JonathanXLin/calipot/README.md

# calipot
Potentiometer based caliper w/ 0.2 mm precision
