JonathanXLin/calipot/Schematic/Schematic Photo.PNG

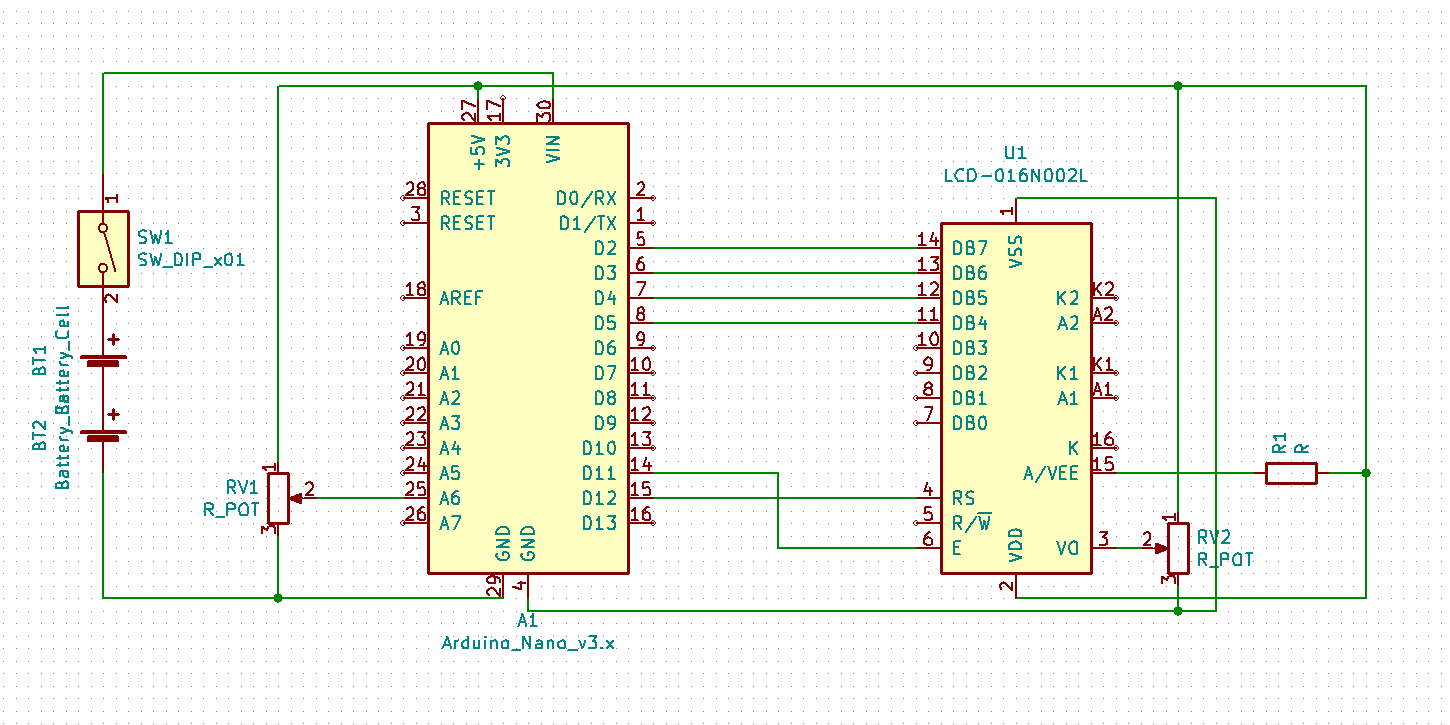
Schematic/Schematic Photo.PNG
