JonathanXLin/calipot/Models/Enclosure.STL

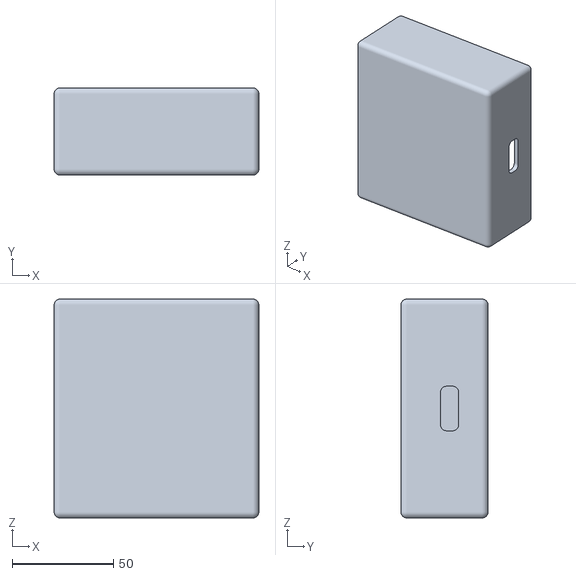
[picture p11: CAD file, 2018-12-14]
Models/Enclosure.STL
101.0 x 43.0 x 108.0
