JonathanXLin/calipot/Schematic/Schematic.kicad_pcb

## KiCad design circuitry/circuitry.sch

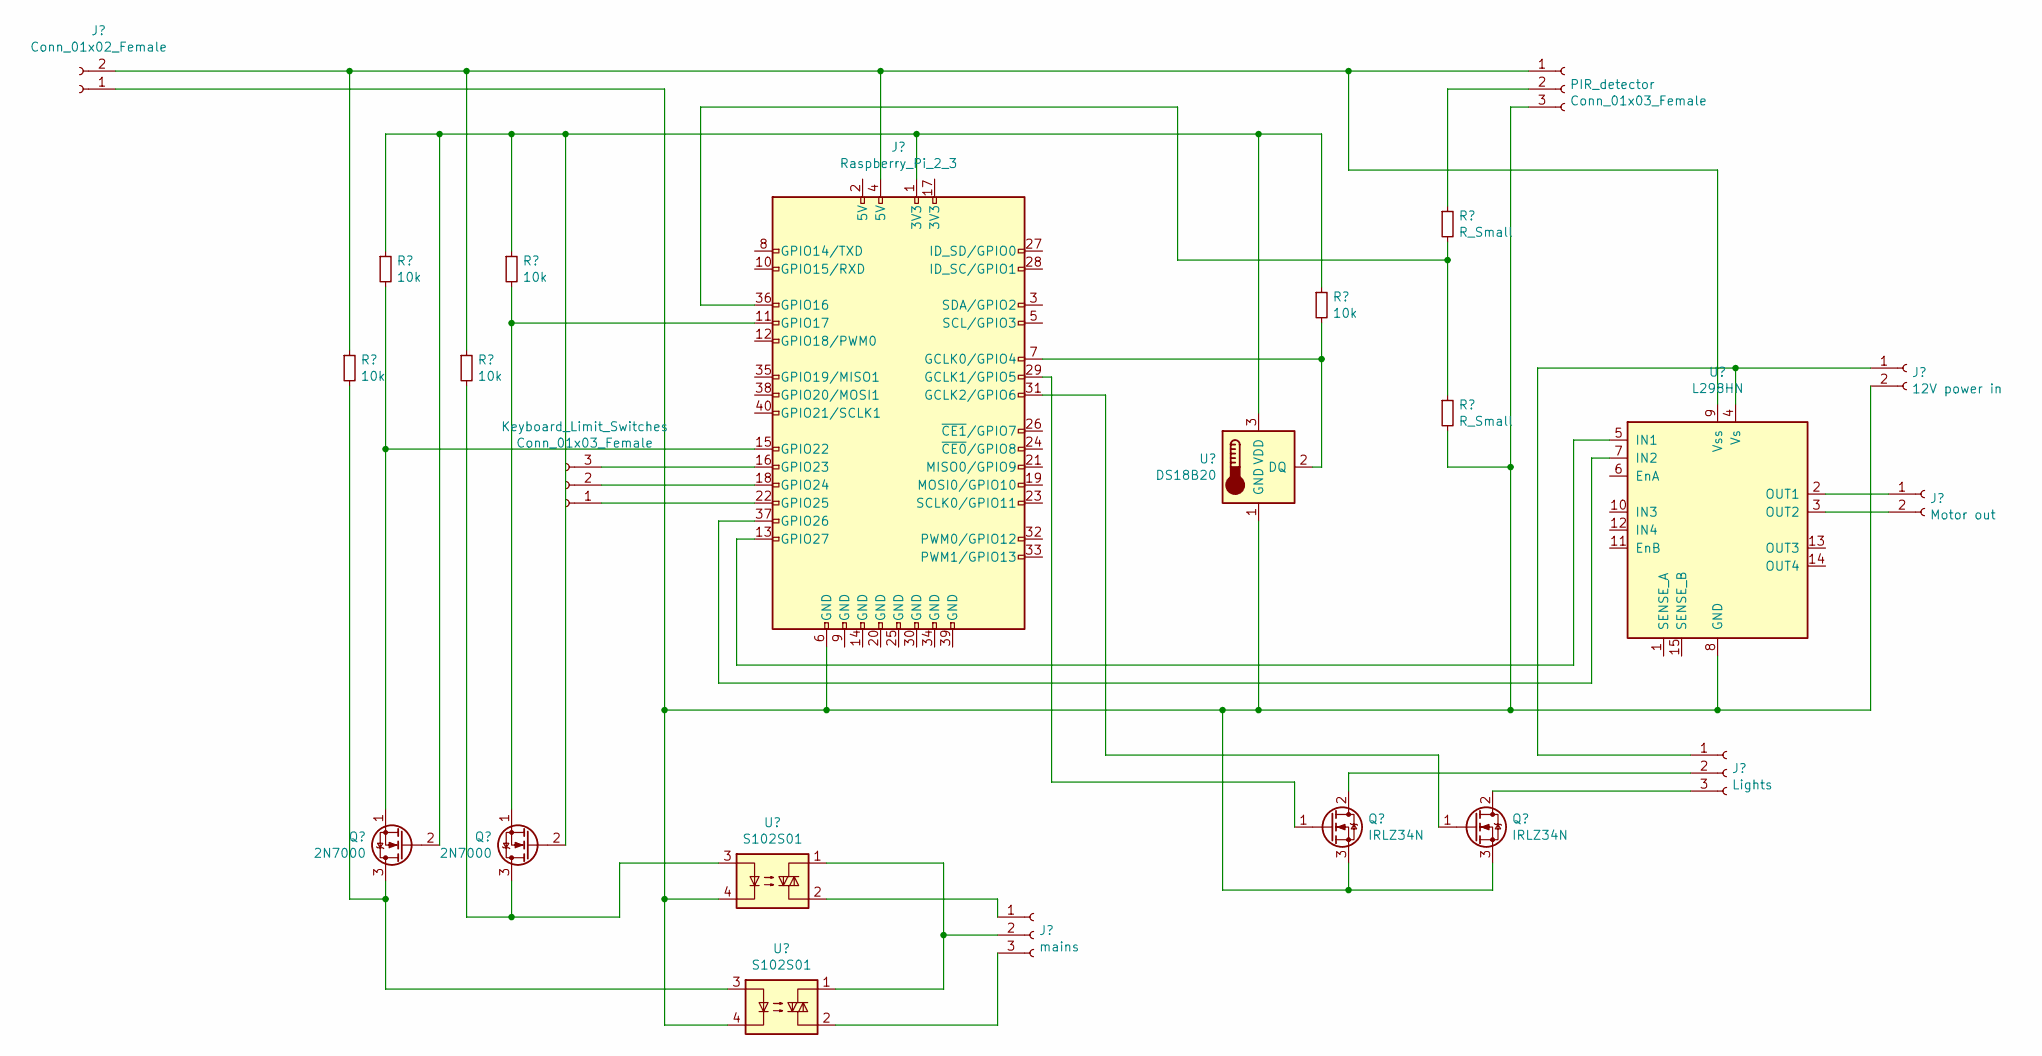
[picture p12: schematic circuitry.sch]

Parts:
Keyboard_Limit_Switches: Conn_01x03_Female
PIR_detector: Conn_01x03_Female
