JonathanXLin/calipot/(commit log)

2018-11-11 Added Schematics
    [Schematic.kicad_pcb, Schematic.sch]
2018-11-15 Update calipot_Arduino/calipot_Arduino.ino
    Added calibration curve
2018-11-16 Create Schematic Photo.PNG
